purduehackers/attendance-camera/README.md

# attendance-camera

📷 Doorframe-mounted Raspberry Pi camera for Hack Night attendance.

- [Documentation](./docs/README.md)
- [CAD files](./cad/v12/)
- [Counting server](./docs/software/Server.md)
- [Rust transport and deployment](./docs/software/Transport.md)
- [Live dashboard](https://attendance.purduehackers.com) · [Deployment status](./docs/software/Deployment-status.md)

Local people counting, occupancy estimates, and an enclosure prototype.
