purduehackers/attendance-camera/cad/v12/plate-2.png

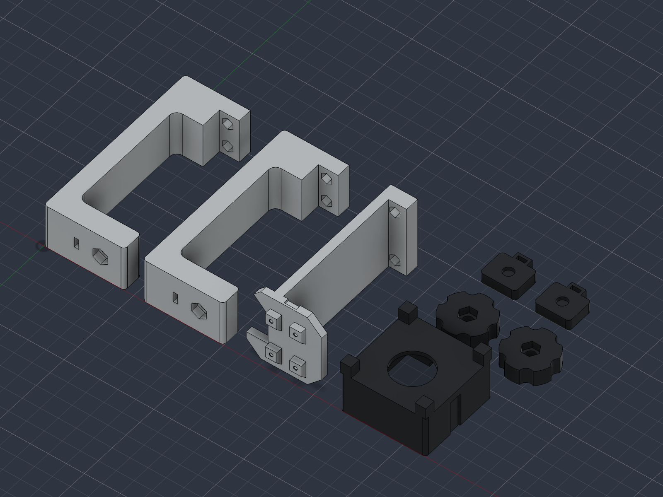
cad/v12/plate-2.png
