purduehackers/attendance-camera/cad/v12/side-profile.png

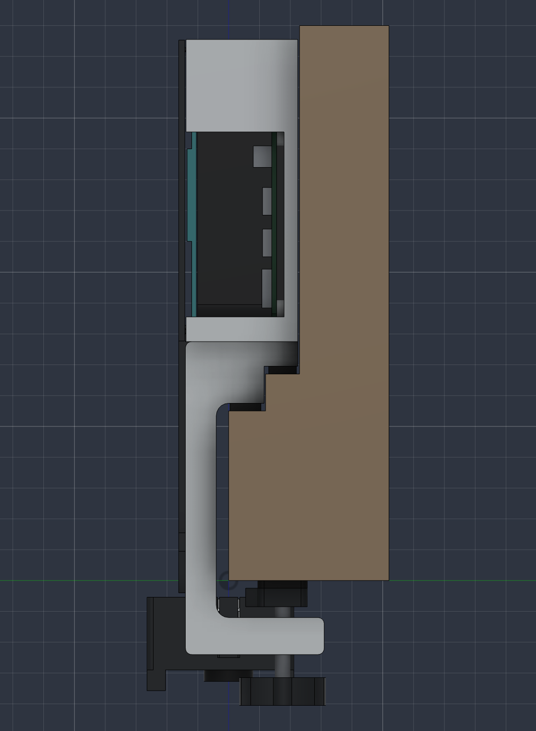
cad/v12/side-profile.png
