purduehackers/attendance-camera/cad/v12/doorframe-camera-clamped-v12.step

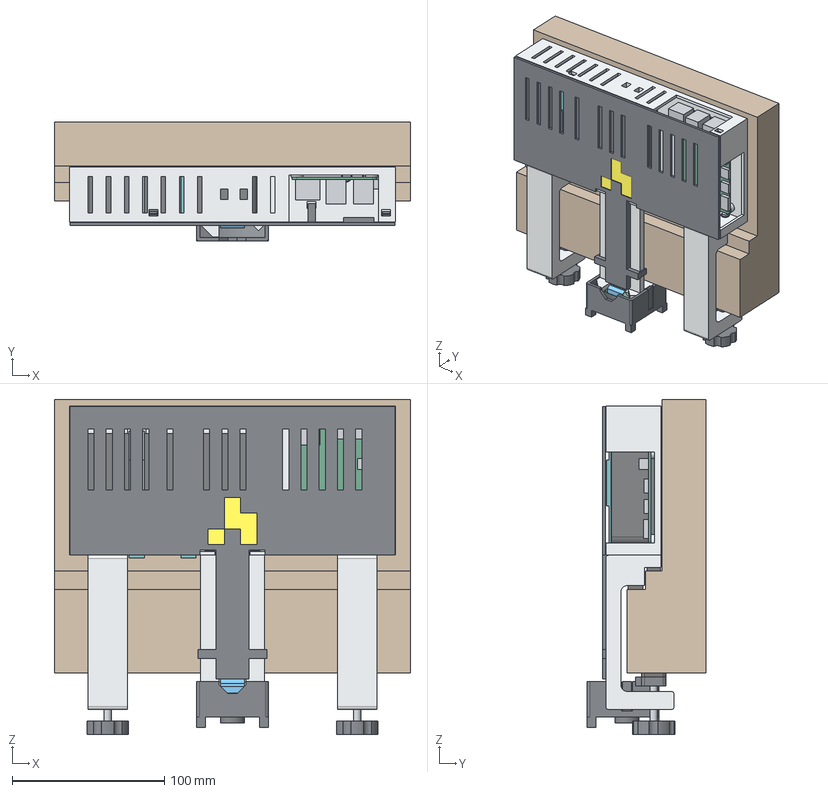
[picture p13: CAD file, 2026-11-09]
cad/v12/doorframe-camera-clamped-v12.step
234.0 x 78.5 x 220.5 mm
