purduehackers/attendance-camera/cad/v12/stl/07-hand-knob-print-two.stl

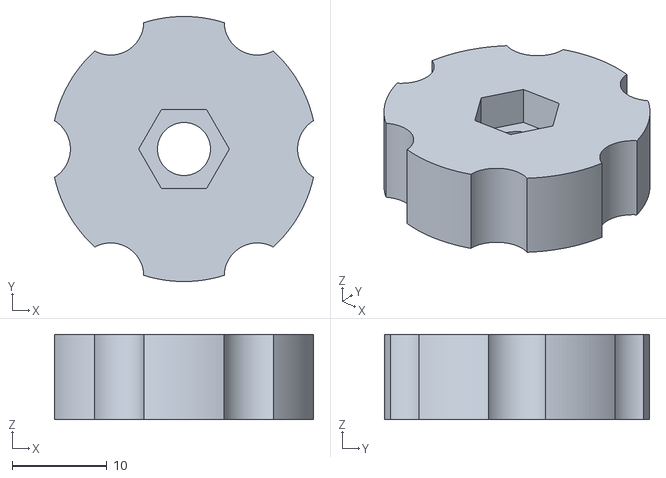
[picture p14: CAD file, 2026-11-09]
cad/v12/stl/07-hand-knob-print-two.stl
27.4 x 28.0 x 9.00
