purduehackers/attendance-camera/cad/v12/stl/02-front-and-ribbon-cover.stl

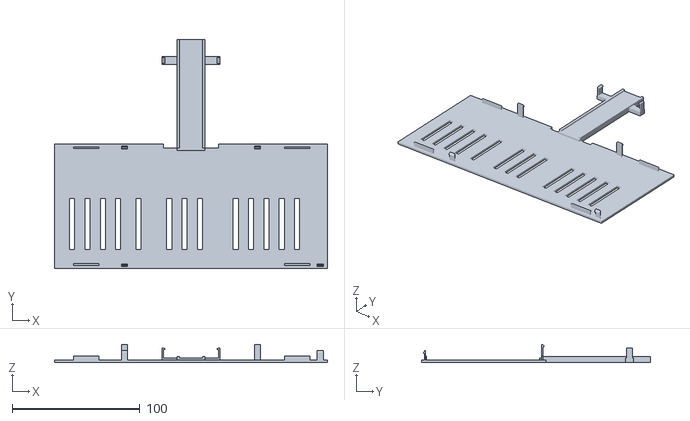
[picture p15: CAD file, 2026-11-09]
cad/v12/stl/02-front-and-ribbon-cover.stl
213.6 x 179.3 x 14.4
