purduehackers/attendance-camera/cad/v12/stl/03-camera-guard-with-bumpers.stl

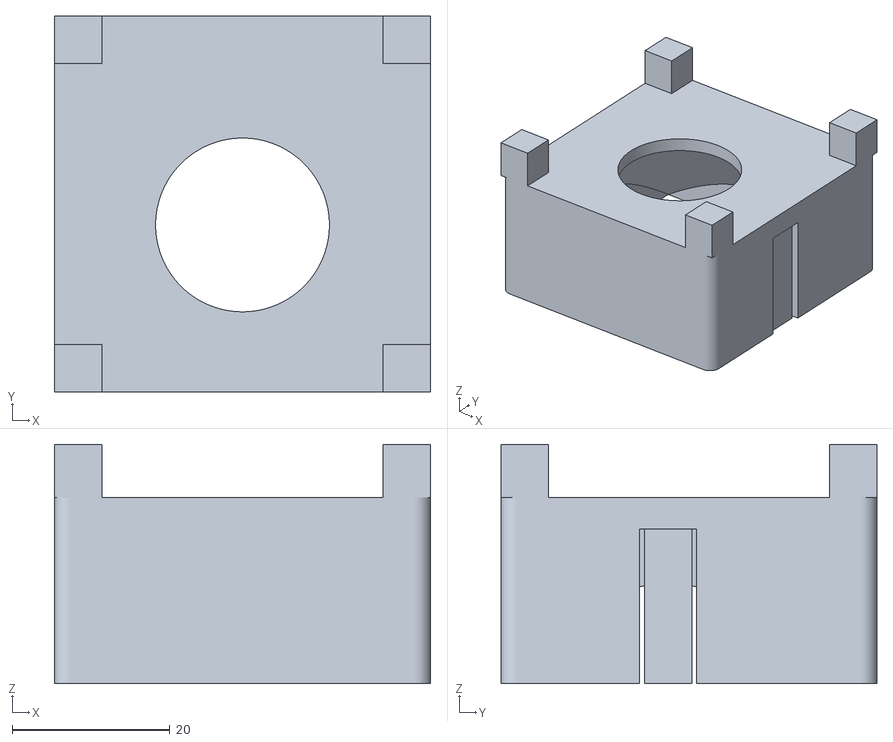
[picture p16: CAD file, 2026-11-09]
cad/v12/stl/03-camera-guard-with-bumpers.stl
47.6 x 47.6 x 30.3
