purduehackers/attendance-camera/cad/v12/stl/04-downward-camera-carrier.stl

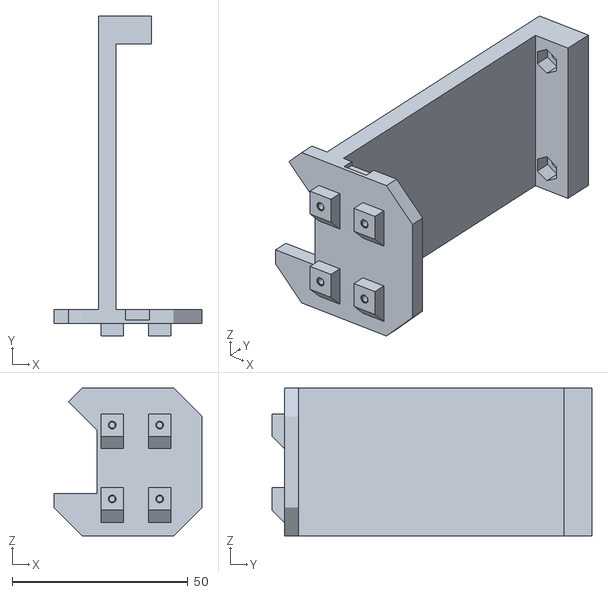
[picture p17: CAD file, 2026-11-09]
cad/v12/stl/04-downward-camera-carrier.stl
42.0 x 91.0 x 42.0
