purduehackers/attendance-camera/cad/v12/stl/01-electronics-case.stl

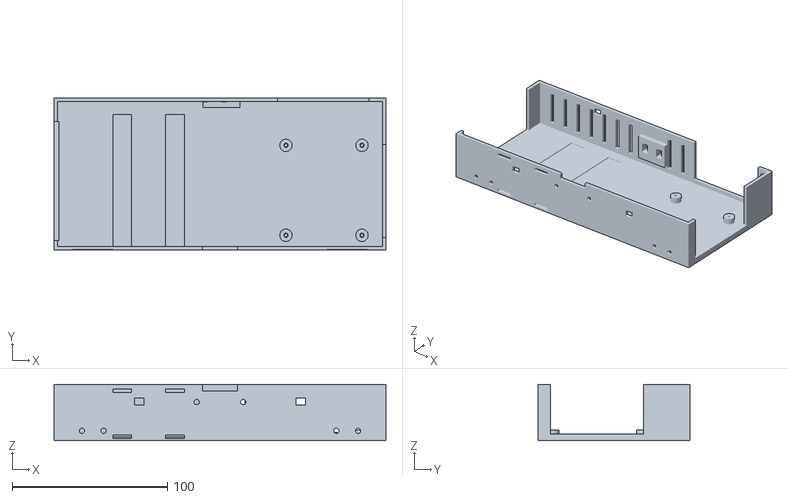
[picture p18: CAD file, 2026-11-09]
cad/v12/stl/01-electronics-case.stl
214.0 x 98.0 x 36.4
