purduehackers/attendance-camera/cad/v12/stl/06-pressure-shoe-print-two.stl

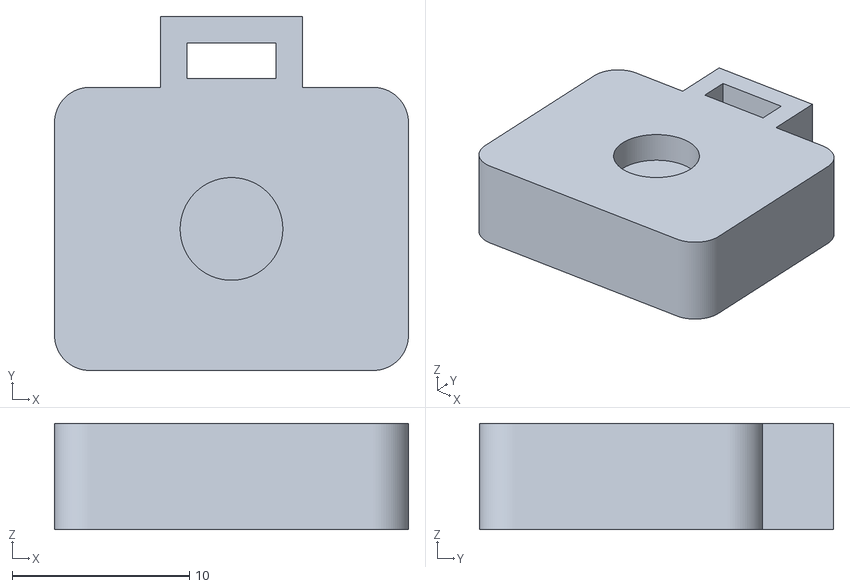
[picture p19: CAD file, 2026-11-09]
cad/v12/stl/06-pressure-shoe-print-two.stl
20.0 x 20.0 x 6.00
