purduehackers/attendance-camera/cad/v12/stl/05-adjustable-clamp-print-two.stl

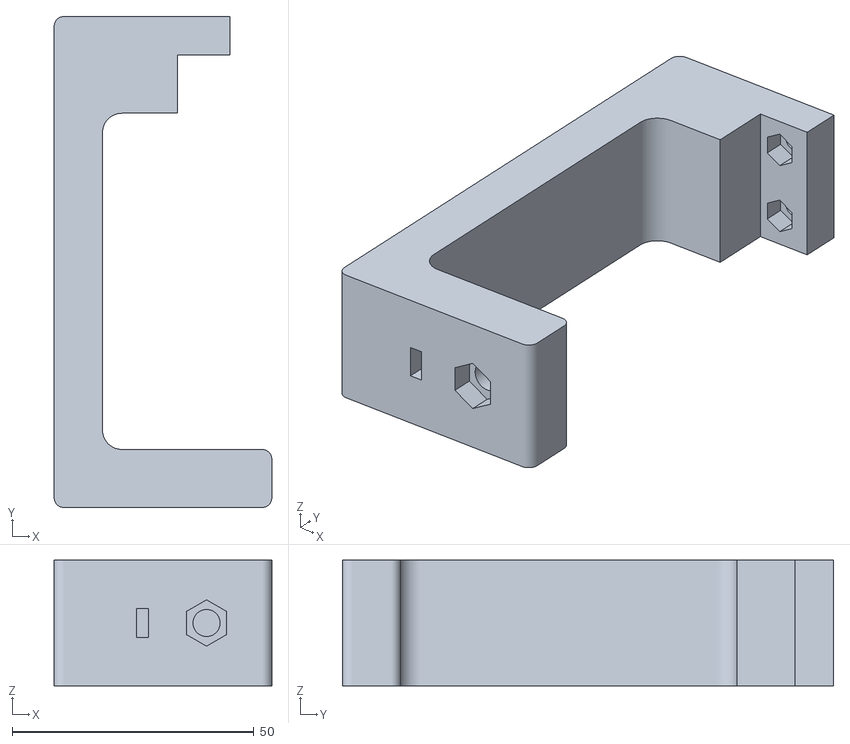
[picture p20: CAD file, 2026-11-09]
cad/v12/stl/05-adjustable-clamp-print-two.stl
45.0 x 101.5 x 26.0
