purduehackers/attendance-camera/cad/v10/doorframe-camera-simple-v10.step

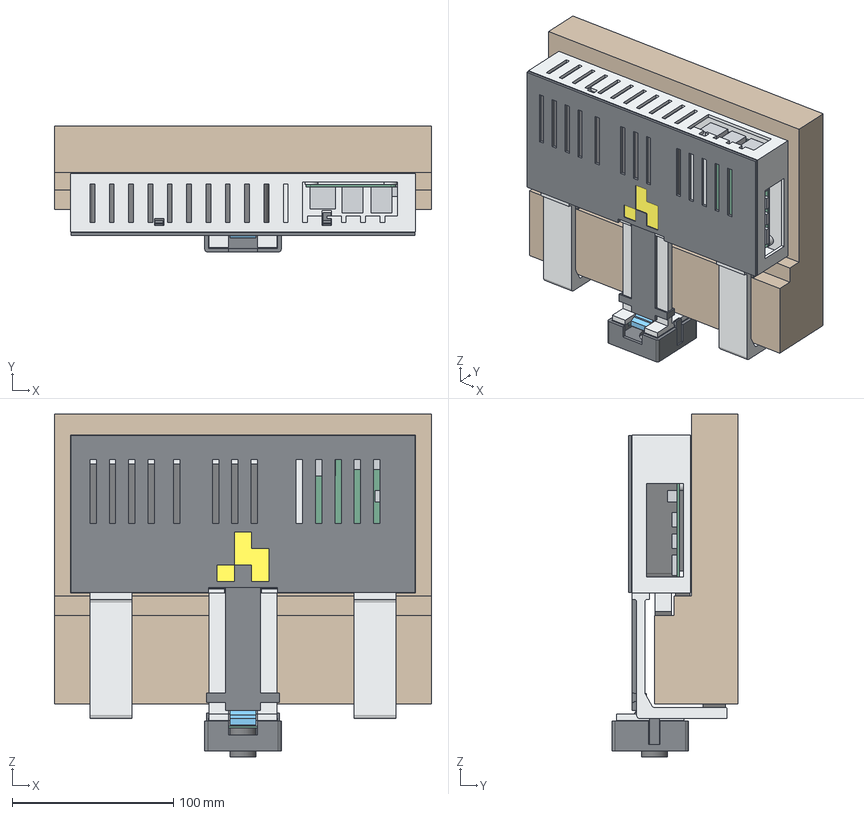
[picture p21: CAD file, 2026-11-09, an earlier design]
cad/v10/doorframe-camera-simple-v10.step
234.0 x 78.5 x 212.7 mm
