purduehackers/attendance-camera/cad/v10/stl/01-integral-case-mount-and-camera-holder.stl

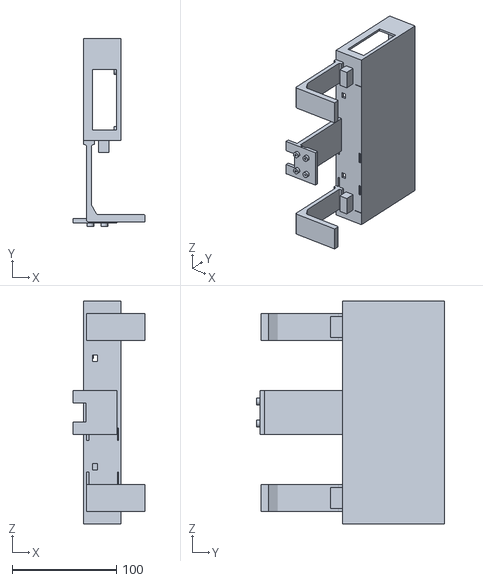
[picture p22: CAD file, 2026-11-09, an earlier design]
cad/v10/stl/01-integral-case-mount-and-camera-holder.stl
68.7 x 180.5 x 214.0
