purduehackers/attendance-camera/cad/v11/doorframe-camera-clamped-v11.step

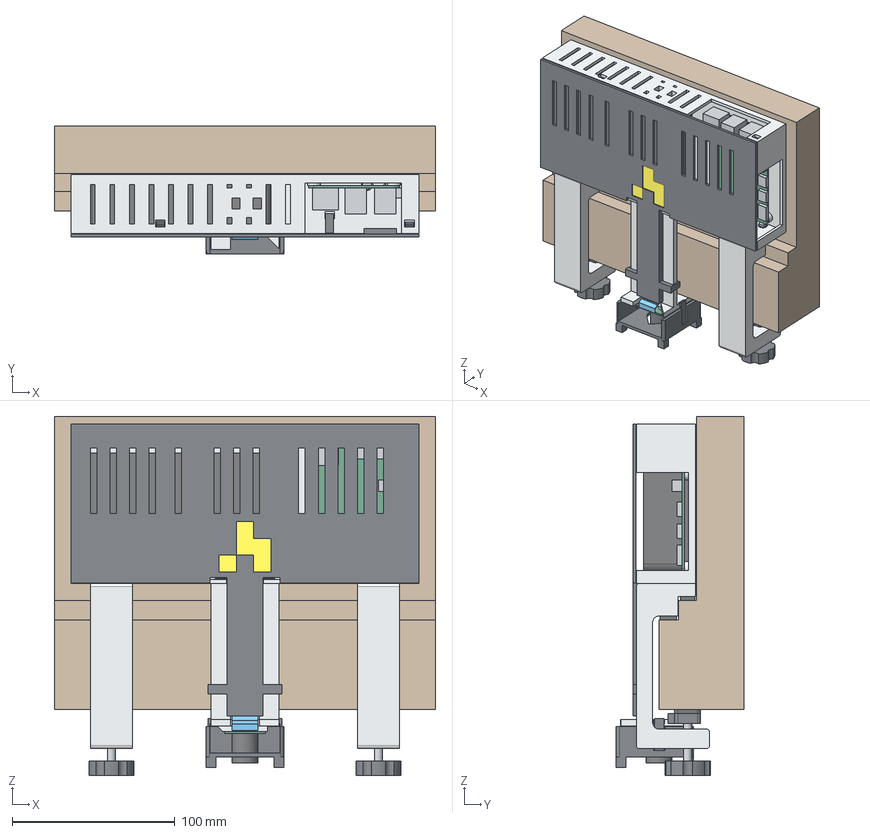
[picture p23: CAD file, 2026-11-09, an earlier design]
cad/v11/doorframe-camera-clamped-v11.step
234.0 x 78.5 x 220.5 mm
