purduehackers/attendance-camera/cad/v9/stl/08-heat-set-test-coupon.stl

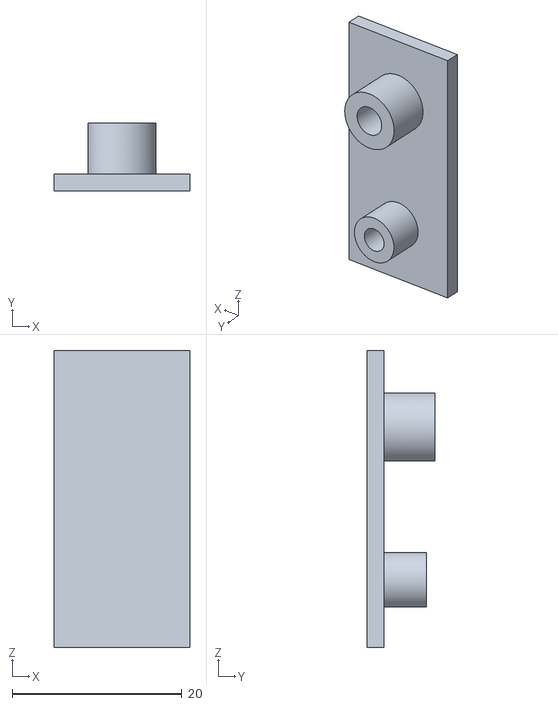
[picture p24: CAD file, 2026-11-09, an earlier design]
cad/v9/stl/08-heat-set-test-coupon.stl
16.0 x 8.00 x 35.0
