purduehackers/attendance-camera/cad/v10/stl/02-snap-on-front-cover.stl

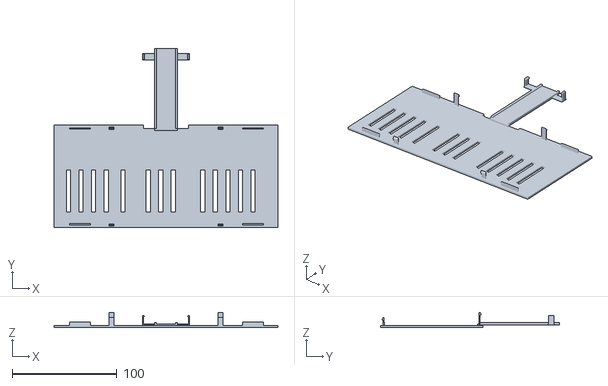
[picture p25: CAD file, 2026-11-09, an earlier design]
cad/v10/stl/02-snap-on-front-cover.stl
213.6 x 170.8 x 14.4
