purduehackers/attendance-camera/cad/v10/stl/07-upward-step-fit-gauge-print-first.stl

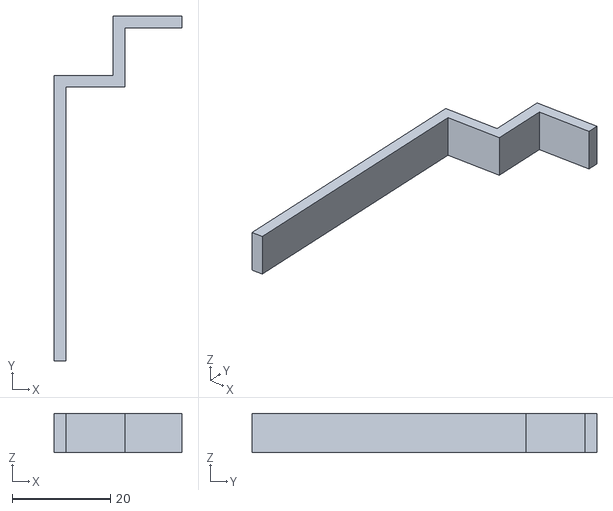
[picture p26: CAD file, 2026-11-09, an earlier design]
cad/v10/stl/07-upward-step-fit-gauge-print-first.stl
26.0 x 70.0 x 8.00
