purduehackers/attendance-camera/(list of files, cad)

Other CAD files:
cad/v11/stl/01-electronics-case.stl
cad/v9/doorframe-camera-simple-v9.step
cad/v11/stl/06-pressure-shoe-print-two.stl
cad/v11/stl/04-downward-camera-carrier.stl
cad/revisions/doorframe-camera-mounted-v3.f3d
cad/revisions/doorframe-camera-v2.f3d
cad/revisions/doorframe-camera-v5.f3d
cad/revisions/doorframe-camera-v6.f3d
cad/v10/doorframe-camera-simple-v10.f3d
cad/v10/stl/03-snap-on-downward-camera-guard.stl
cad/v10/stl/08-screw-fit-test-coupon.stl
cad/v11/doorframe-camera-clamped-v11.f3d
cad/v11/stl/02-front-and-ribbon-cover.stl
cad/v11/stl/03-camera-guard-with-bumpers.stl
cad/v11/stl/05-adjustable-clamp-print-two.stl
cad/v11/stl/07-hand-knob-print-two.stl
cad/v12/doorframe-camera-clamped-v12.f3d
cad/v5/doorframe-camera-hanging-v5.f3d
cad/v6/doorframe-camera-simple-v6.f3d
cad/v7/doorframe-camera-simple-v7.f3d
cad/v8/doorframe-camera-simple-v8.f3d
cad/v9/doorframe-camera-simple-v9.f3d
