purduehackers/attendance-camera/install/README.md

# Installation files

Follow the [setup](../docs/software/Setup.md) and [installation instructions](../docs/software/Install.md). Run the installer on the Pi only.

The templates are rendered by [`src/render_config.py`](../src/render_config.py); machine-specific outputs belong in ignored `build/config/`.
