purduehackers/attendance-camera/cad/v9/PRINT-ADMIN-NOTES.md

# v9 print operator notes

The current [print operator notes](../../docs/hardware/v9/printing.md) are in the documentation alongside the [assembly instructions](../../docs/hardware/v9/assembly.md).
