purduehackers/attendance-camera/(commit log)

2026-11-09 Add camera feed, v9 enclosure CAD, and hardware documentation
    [01-integral-case-mount-and-camera-holder.stl, 02-snap-on-front-cover.stl, 03-snap-on-downward-camera-guard.stl, 07-upward-step-fit-gauge-print-first.stl, 08-heat-set-test-coupon.stl, doorframe-camera-hanging-v5.f3d, doorframe-camera-mounted-v3.f3d, doorframe-camera-simple-v6.f3d]
2026-11-09 Add Rust video relay and PH Redis transport
2026-11-09 Use FFmpeg's RTSP timeout option in camera publisher
2026-11-09 Record live relay verification and remaining Pi cutover
2026-11-09 Show the camera preview by default and recover from dropped requests
2026-11-09 Use direct PETG screw mounts in the v10 camera enclosure
    [01-integral-case-mount-and-camera-holder.stl, 02-snap-on-front-cover.stl, 03-snap-on-downward-camera-guard.stl, 07-upward-step-fit-gauge-print-first.stl, 08-screw-fit-test-coupon.stl, doorframe-camera-simple-v10.f3d, doorframe-camera-simple-v10.step]
2026-11-09 Add adjustable doorframe clamps and flatter v11 print layout
    [01-electronics-case.stl, 02-front-and-ribbon-cover.stl, 03-camera-guard-with-bumpers.stl, 04-downward-camera-carrier.stl, 05-adjustable-clamp-print-two.stl, 06-pressure-shoe-print-two.stl, 07-hand-knob-print-two.stl, doorframe-camera-clamped-v11.f3d]
2026-11-09 Clear larger power plugs and document v11 hardware sourcing
    [01-electronics-case.stl, doorframe-camera-clamped-v11.f3d, doorframe-camera-clamped-v11.step]
2026-11-09 Enclose camera guard and clear battery strap routes in v12
    [01-electronics-case.stl, 02-front-and-ribbon-cover.stl, 03-camera-guard-with-bumpers.stl, 04-downward-camera-carrier.stl, 05-adjustable-clamp-print-two.stl, 06-pressure-shoe-print-two.stl, 07-hand-knob-print-two.stl, doorframe-camera-clamped-v12.f3d]
